sadekbaroudi/fflx/cases/plates/fflx-split-plate-cover-fox1.stl

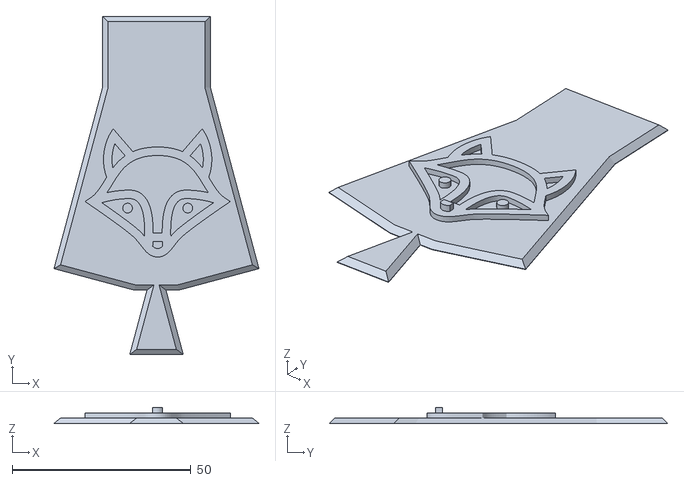
[picture p2: CAD file, 2022-07-21]
cases/plates/fflx-split-plate-cover-fox1.stl
57.3 x 94.6 x 4.60
