sadekbaroudi/fflx/svgs/fflx-edgecuts.dxf

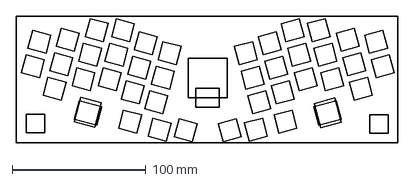
[picture p3: CAD file, 2022-07-21]
svgs/fflx-edgecuts.dxf
285.0 x 94.6 mm
