sadekbaroudi/fflx/cases/plates/fflx-split-plate-cover-fox4.stl

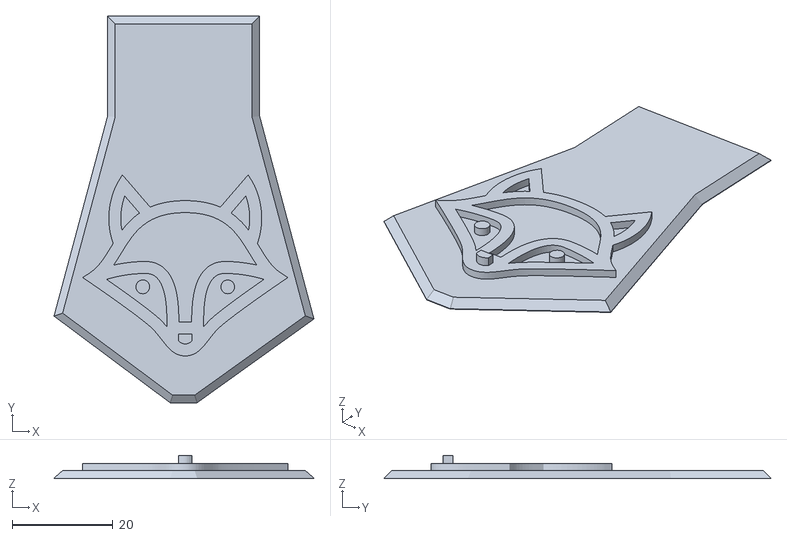
[picture p4: CAD file, 2022-07-21]
cases/plates/fflx-split-plate-cover-fox4.stl
51.5 x 76.6 x 4.60
