sadekbaroudi/fflx/svgs/ffkb-template.dxf

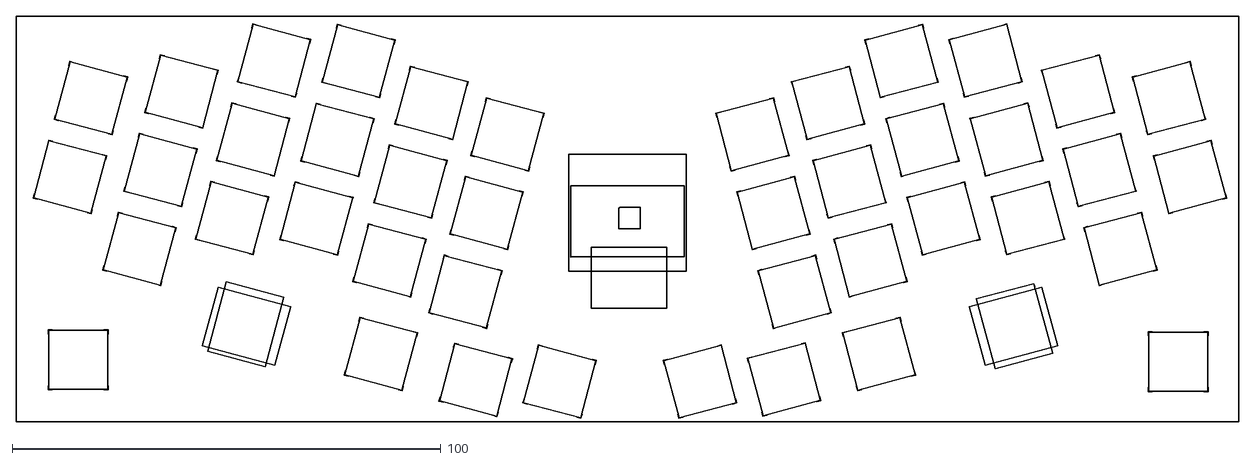
[picture p5: CAD file, 2022-07-04]
svgs/ffkb-template.dxf
285.0 x 94.6
