sadekbaroudi/fflx/cases/plates/fflx-split-plate-cover-chamfered-fox1.stl

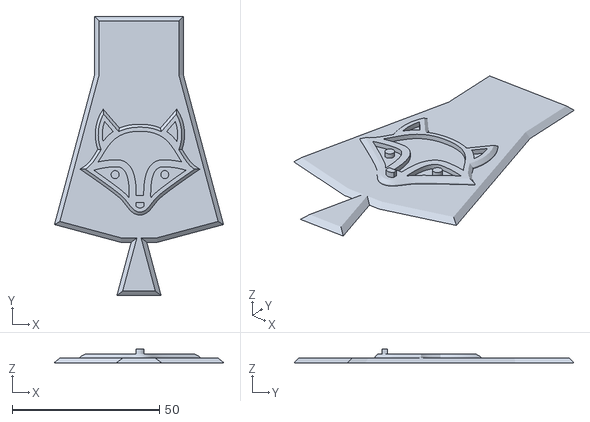
[picture p6: CAD file, 2022-07-21]
cases/plates/fflx-split-plate-cover-chamfered-fox1.stl
57.3 x 94.6 x 4.60
