sadekbaroudi/fflx/cases/plates/fflx-split-plate-cover-chamfered-fox2.stl

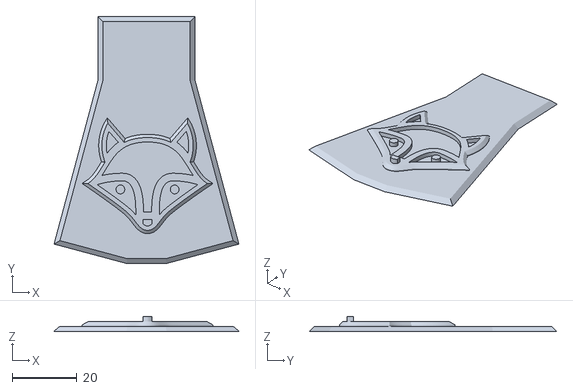
[picture p7: CAD file, 2022-07-21]
cases/plates/fflx-split-plate-cover-chamfered-fox2.stl
57.3 x 76.6 x 4.60
