sadekbaroudi/fflx/cases/plates/fflx-split-plate-cover-chamfered-fox3.stl

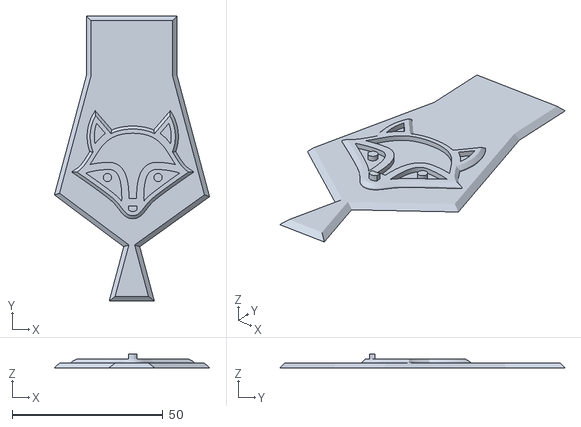
[picture p8: CAD file, 2022-07-21]
cases/plates/fflx-split-plate-cover-chamfered-fox3.stl
51.5 x 94.6 x 4.60
