sadekbaroudi/fflx/cases/plates/Body2.stl

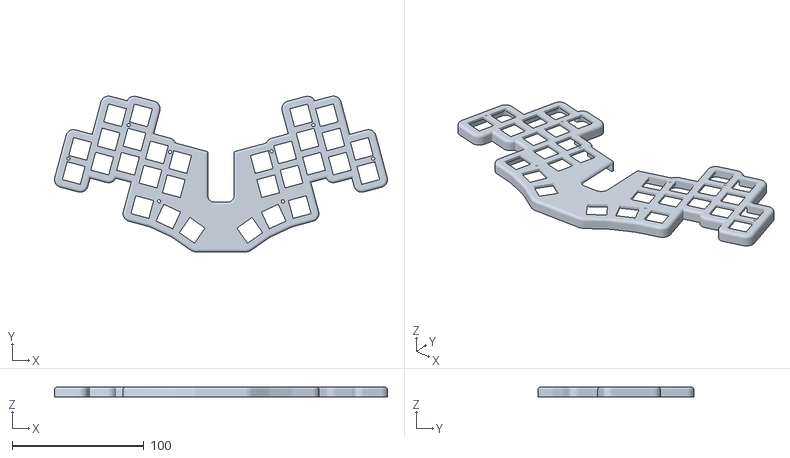
[picture p9: CAD file, 2022-07-21]
cases/plates/Body2.stl
252.9 x 118.4 x 7.60
