sadekbaroudi/fflx/cases/plates/fflx-ec-split-left.stl

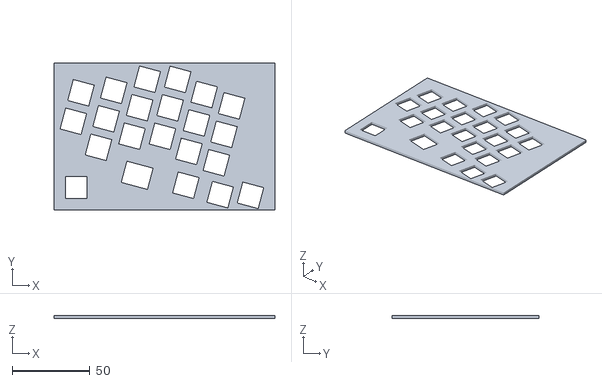
[picture p11: CAD file, 2022-07-11]
cases/plates/fflx-ec-split-left.stl
142.5 x 94.6 x 2.00
