sadekbaroudi/fflx/cases/plates/fflx-ne.stl

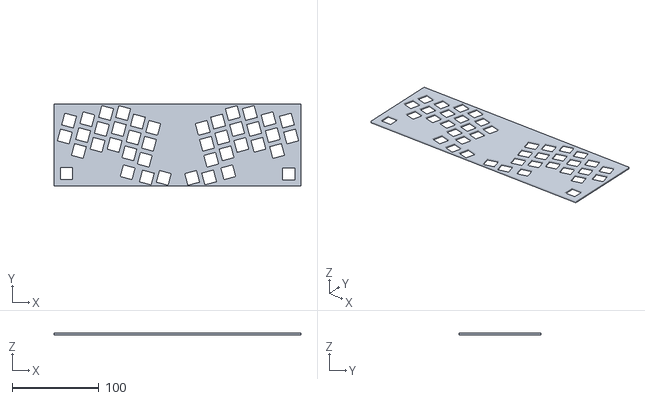
[picture p12: CAD file, 2022-07-06]
cases/plates/fflx-ne.stl
285.0 x 94.6 x 2.00
