sadekbaroudi/fflx/cases/plates/fflx-ec.stl

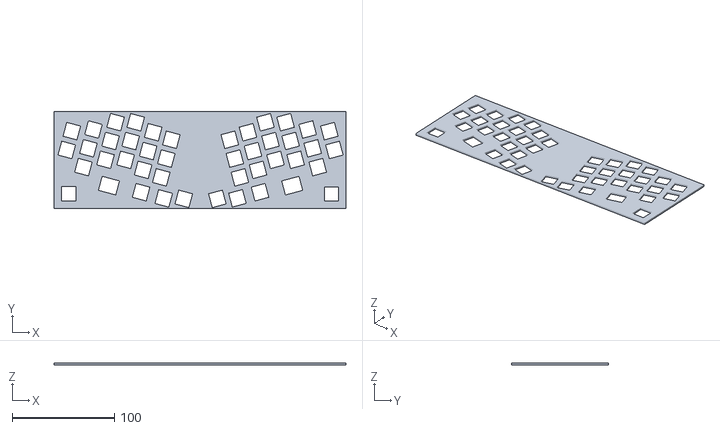
[picture p13: CAD file, 2022-07-06]
cases/plates/fflx-ec.stl
285.0 x 94.6 x 2.00
