sadekbaroudi/fflx/cases/plates/fflx-ev-c.stl

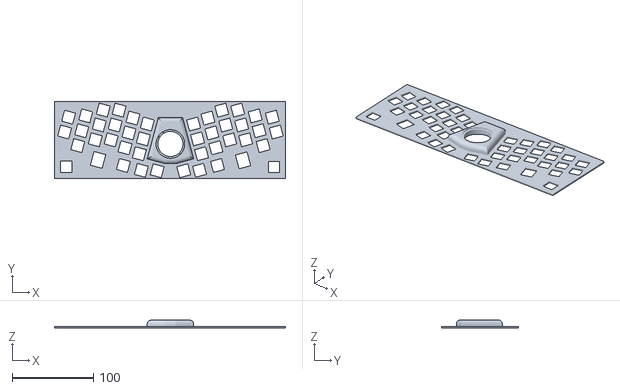
[picture p14: CAD file, 2022-07-06]
cases/plates/fflx-ev-c.stl
285.0 x 94.6 x 10.0
