sadekbaroudi/fflx/cases/plates/fflx-ec-c.stl

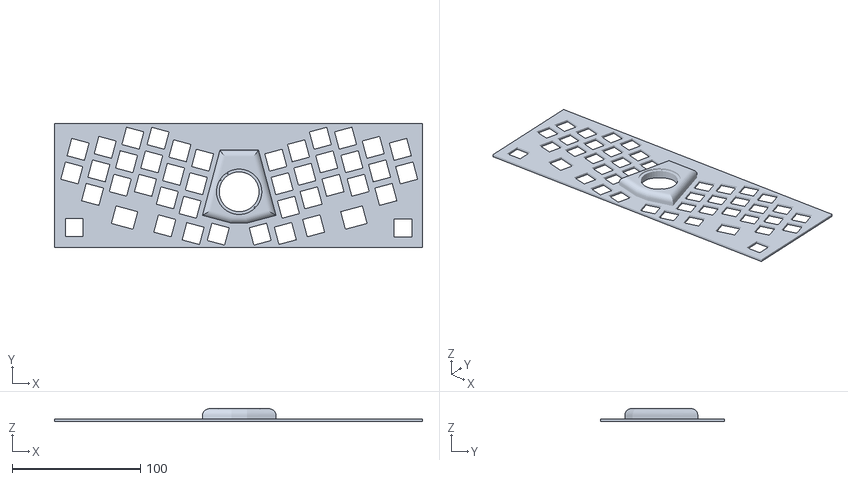
[picture p15: CAD file, 2022-07-04]
cases/plates/fflx-ec-c.stl
287.0 x 96.6 x 10.0
