sadekbaroudi/fflx/(list of files, cad)

Other CAD files:
cases/plates/fflx-split-plate-cover-chamfered-fox4.stl
cases/plates/fflx-split-plate-cover-fox3.stl
cases/plates/fflx-ev-split-left.stl
cases/plates/fflx-ev-split-right.stl
cases/plates/fflx-ec-split-right.stl
cases/plates/fflx-ne-split-left.stl
cases/plates/fflx-ne-split-right.stl
cases/plates/fflx-ev.stl
cases/plates/fflx-ne-c.stl
