sadekbaroudi/fflx/pcb/mx-choc/fflx-layout-tester.pdf

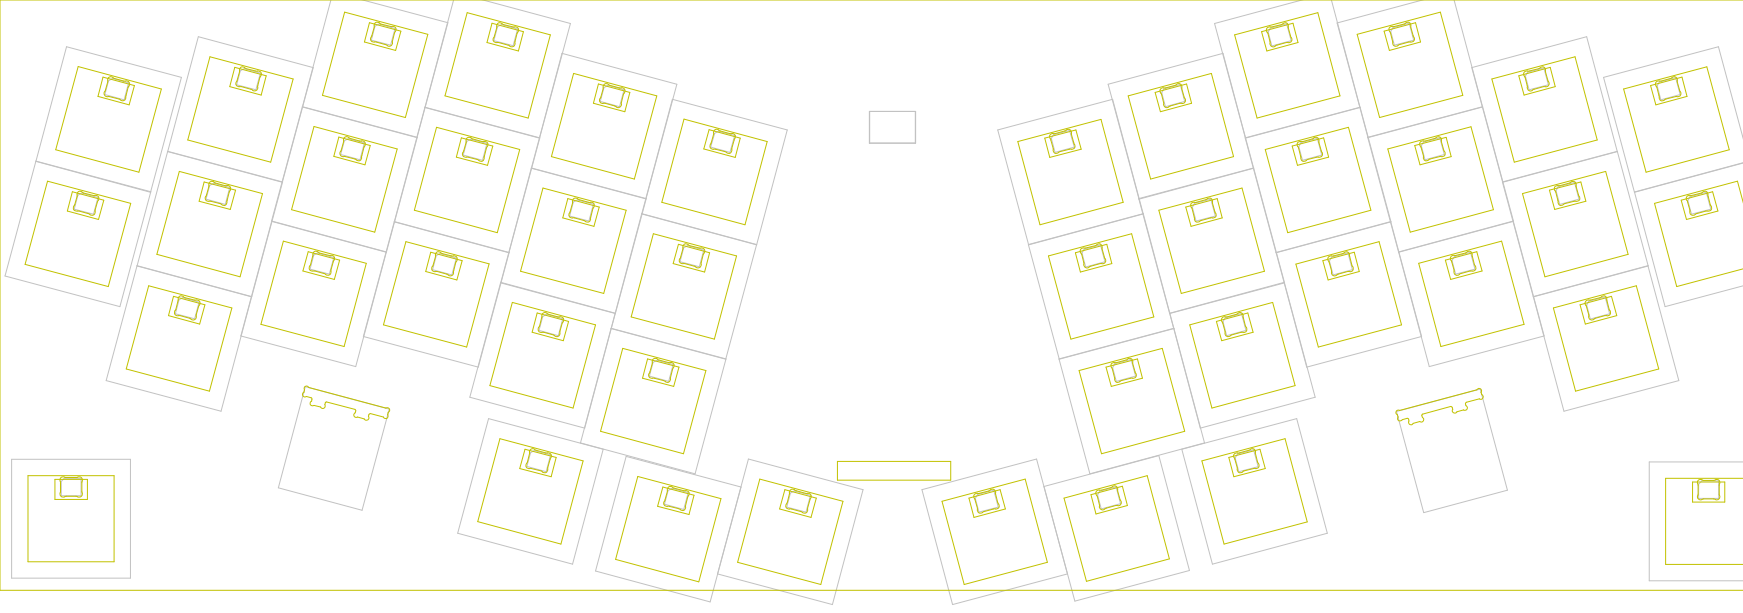
[picture p16: page 1]
