sadekbaroudi/fflx/(list of files, drawings)

Other design files:
pcb/mx-choc/ffkb.dsn
