sadekbaroudi/fflx/(commit log)

2022-05-22 initial commit of fflx
    [ffkb-B_Cu.gbr, ffkb-B_Mask.gbr, ffkb-B_Paste.gbr, ffkb-B_Silkscreen.gbr, ffkb-Edge_Cuts.gbr, ffkb-F_Cu.gbr, ffkb-F_Mask.gbr, ffkb-F_Paste.gbr]
2022-05-22 removing unneeded files
    [ffkb-B_Cu.gbr, ffkb-B_Mask.gbr, ffkb-B_Paste.gbr, ffkb-B_Silkscreen.gbr, ffkb-Edge_Cuts.gbr, ffkb-F_Cu.gbr, ffkb-F_Mask.gbr, ffkb-F_Paste.gbr]
2022-05-24 updated schematic to use STM32 directly, similar to stemcell
    [ffkb.kicad_pcb, ffkb.kicad_sch]
2022-05-26 updated schematic to make the pcb compatible with both an integrated mcu and a controller board
    [ffkb.kicad_pcb, ffkb.kicad_sch]
2022-06-16 fixed schematics, will check one more time, then time to route
    [ffkb.kicad_pcb, ffkb.kicad_sch]
2022-06-17 updated schematics a bit and did a little bit of routing
    [ffkb.kicad_pcb, ffkb.kicad_sch]
2022-06-17 a lot more routing, about 40 percent done
    [ffkb.kicad_pcb]
2022-06-17 core routing done, usb-c, leds, and STM32, need the rest of the board
    [ffkb.kicad_pcb, ffkb.kicad_sch]
2022-06-18 more routing
    [ffkb.kicad_pcb]
2022-06-18 almost done routing...
    [ffkb.kicad_pcb, ffkb.kicad_sch]
2022-06-18 prototype complete and ordered
    [ffkb-B_Cu.gbr, ffkb-B_Mask.gbr, ffkb-B_Paste.gbr, ffkb-B_Silkscreen.gbr, ffkb-Edge_Cuts.gbr, ffkb-F_Cu.gbr, ffkb-F_Mask.gbr, ffkb-F_Paste.gbr]
2022-06-20 removed a duplicate R4 resistor, when sending to JLCPCB we skipped that resistor for SMT assembly, so this is effectively the first proto pcb that I fabricated
    [ffkb-B_Cu.gbr, ffkb-B_Mask.gbr, ffkb-B_Paste.gbr, ffkb-B_Silkscreen.gbr, ffkb-Edge_Cuts.gbr, ffkb-F_Cu.gbr, ffkb-F_Mask.gbr, ffkb-F_Paste.gbr]
2022-07-04 fixed usb location to extrude a bit out, and fixed one mounting hole that wasn't aligned vertically
    [ffkb-B_Cu.gbr, ffkb-B_Mask.gbr, ffkb-B_Paste.gbr, ffkb-B_Silkscreen.gbr, ffkb-Edge_Cuts.gbr, ffkb-F_Cu.gbr, ffkb-F_Mask.gbr, ffkb-F_Paste.gbr]
2022-07-04 added cirque plate and svgs
    [ffkb-template.dxf, fflx-ec-c.stl]
2022-07-05 moved usb port back down as not to collide with the case
    [ffkb-B_Cu.gbr, ffkb-B_Mask.gbr, ffkb-B_Paste.gbr, ffkb-B_Silkscreen.gbr, ffkb-Edge_Cuts.gbr, ffkb-F_Cu.gbr, ffkb-F_Mask.gbr, ffkb-F_Paste.gbr]
2022-07-06 added new plates
    [fflx-c.stl, fflx-ev-c.stl]
2022-07-06 non cirque plates
    [fflx-ec.stl, fflx-ev.stl, fflx-ne-c.stl, fflx-ne.stl]
2022-07-07 added split plates for smaller printer
    [fflx-ne-split-left.stl, fflx-ne-split-right.stl]
2022-07-11 split plates for all encoder variations
    [fflx-ec-split-left.stl, fflx-ec-split-right.stl, fflx-ev-split-left.stl, fflx-ev-split-right.stl]
2022-07-21 added more plates, cases, and svgs
    [Body2.stl, fflx-edgecuts.dxf, fflx-split-plate-cover-chamfered-fox1.stl, fflx-split-plate-cover-chamfered-fox2.stl, fflx-split-plate-cover-chamfered-fox3.stl, fflx-split-plate-cover-chamfered-fox4.stl, fflx-split-plate-cover-fox1.stl, fflx-split-plate-cover-fox2.stl]
2024-07-09 sync with local
    [fox-ne-B_Cu.gbl, fox-ne-B_Mask.gbs, fox-ne-B_Paste.gbp, fox-ne-B_Silkscreen.gbo, fox-ne-Edge_Cuts.gm1, fox-ne-F_Cu.gtl, fox-ne-F_Mask.gts, fox-ne-F_Paste.gtp]
